Oluwasholape/SS2026_AES_LAB_GROUP_A2/project/arduino/README.md

# Arduino

Cpntains all the files used for the 3 Arduino UNO WIFI REV 2s, and the sensors connected to them
