Oluwasholape/SS2026_AES_LAB_GROUP_A2/labs/lab02_BLE/README.md

# Lab 02: Arduino WiFi, Sensors and Bluetooth Low Energy

#### Done by:
- Boiddo, Sumon
- Nnachi-Egwu, Nnaemeka
- Oyemade, Oluwasholape Daniel
- Tuhin, Md Tawhidur Rahman
