Oluwasholape/SS2026_AES_LAB_GROUP_A2/project/AtmosPi_Illustration.png

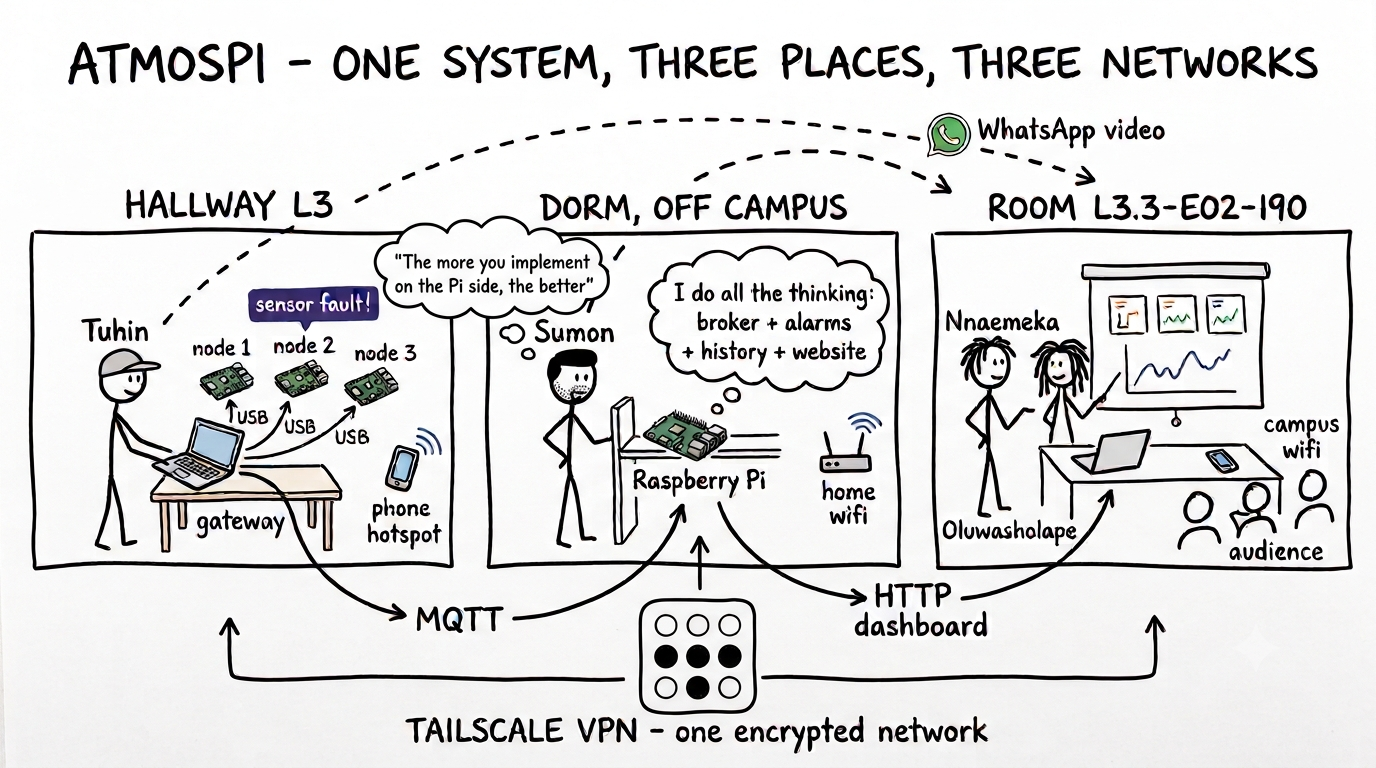
project/AtmosPi_Illustration.png
