Oluwasholape/SS2026_AES_LAB_GROUP_A2/labs/lab02_BLE/BLE_Receiver_Emeka.ino

// Received from https://github.com/Oluwasholape/SS2026_AES_LAB_GROUP_A2/blob/main/Lab/BLE_Sender_Oluwasholape.ino
// Description: This file processes the signal emitted by the sender script.

#include <ArduinoBLE.h>

void setup() {
  Serial.begin(9600);
  if (!BLE.begin()) while (1);
  BLE.scanForName("SensorNode");
}

void loop() {
  BLEDevice peripheral = BLE.available();

  if (peripheral) {
    BLE.stopScan();
    if (peripheral.connect()) {
      if (peripheral.discoverAttributes()) {
        BLECharacteristic sensorChar = peripheral.characteristic("2A6E");
        if (sensorChar && sensorChar.canRead()) {
          while (peripheral.connected()) {
            sensorChar.read();
            const uint8_t* buf = sensorChar.value();
            unsigned int value = buf[0] | (buf[1] << 8);
            Serial.print("Sensor value: ");
            Serial.println(value);
            delay(500);
          }
        }
      }
      peripheral.disconnect();
    }
    BLE.scanForName("SensorNode");
  }
}
