Oluwasholape/SS2026_AES_LAB_GROUP_A2/(commit log)

2026-05-12 Update comment to reflect correct sender file
    [BLE_Receiver_Emeka.ino]
2026-07-04 Add README.md for Arduino project
    Contains all the files used for the 3 Arduino UNO WIFI REV 2s, and the sensors connected to them.
2026-07-04 Add README.md for Raspberry Pi project
2026-07-05 Revise work package owners and sensor details
    Updated work package ownership and sensor sections in README.
2026-07-07 Create Raspberry.Pi.MP4
    Added
